EasySensors/easyPIRmultisensorsBox2/pics/Easy_PIR_Back.png

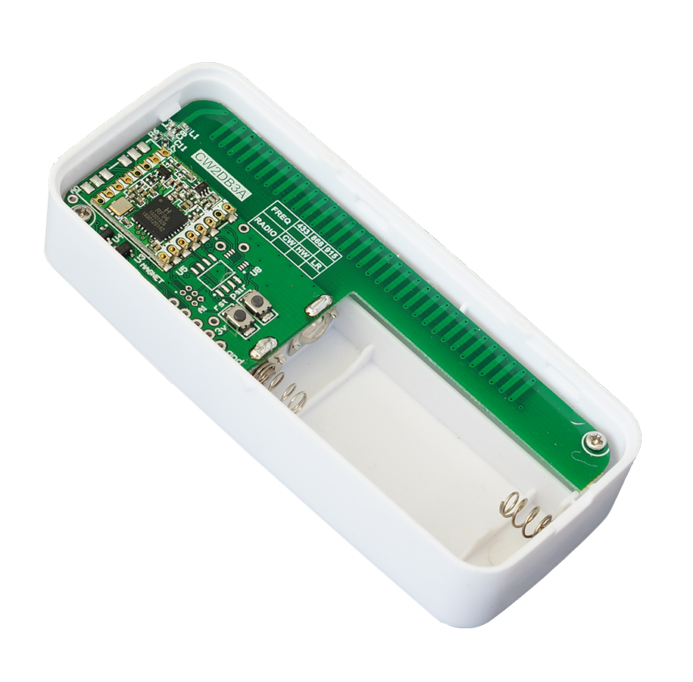
pics/Easy_PIR_Back.png
