EasySensors/easyPIRmultisensorsBox2/pics/Easy_PIR_MAIN.jpg

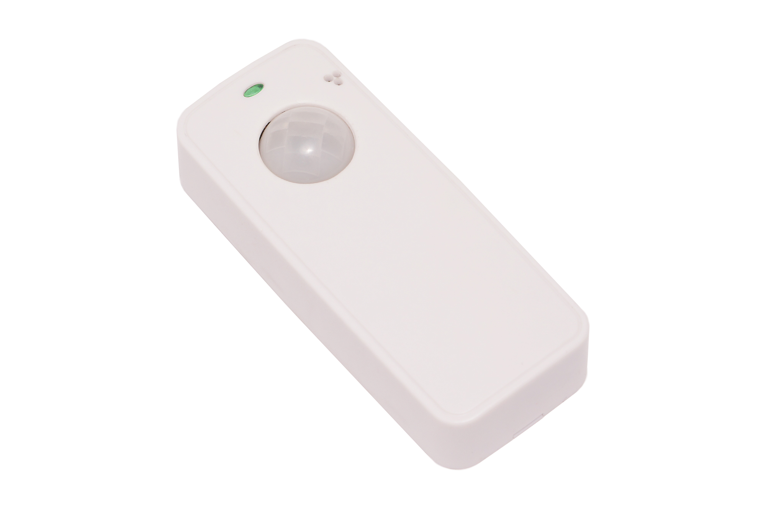
pics/Easy_PIR_MAIN.jpg
