EasySensors/easyPIRmultisensorsBox2/pics/Easy_PIR_PCB_TOP.jpg

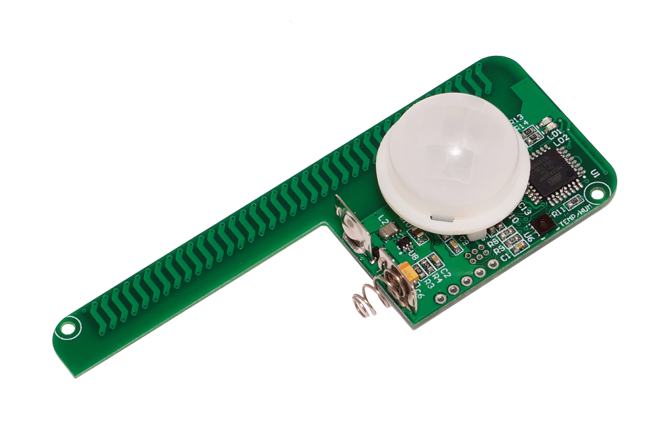
pics/Easy_PIR_PCB_TOP.jpg
