EasySensors/easyPIRmultisensorsBox2/pics/Easy_PIR_TOP.png

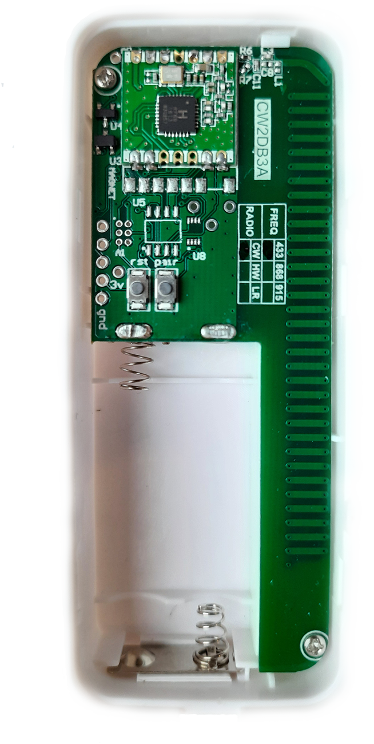
pics/Easy_PIR_TOP.png
