EasySensors/easyPIRmultisensorsBox2/pics/replcePIR2.jpg

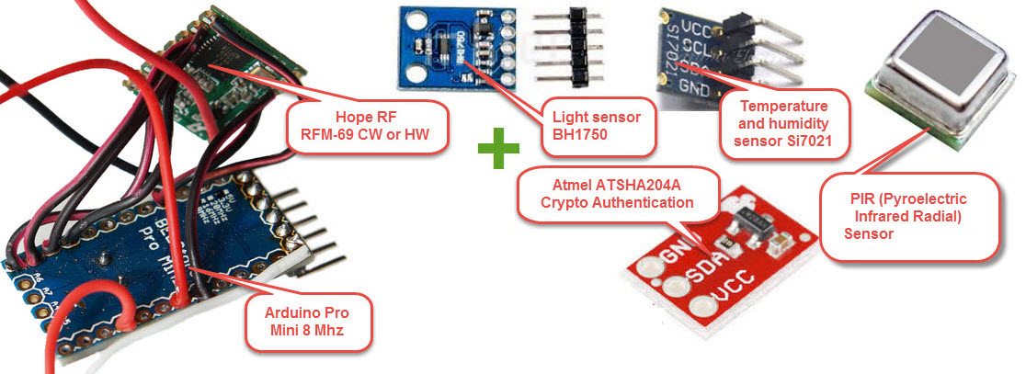
pics/replcePIR2.jpg
