EasySensors/easyPIRmultisensorsBox2/UNIVERSAL_WINDOW_SENSOR_NEWTEMPHUM_FLOOD.PDF

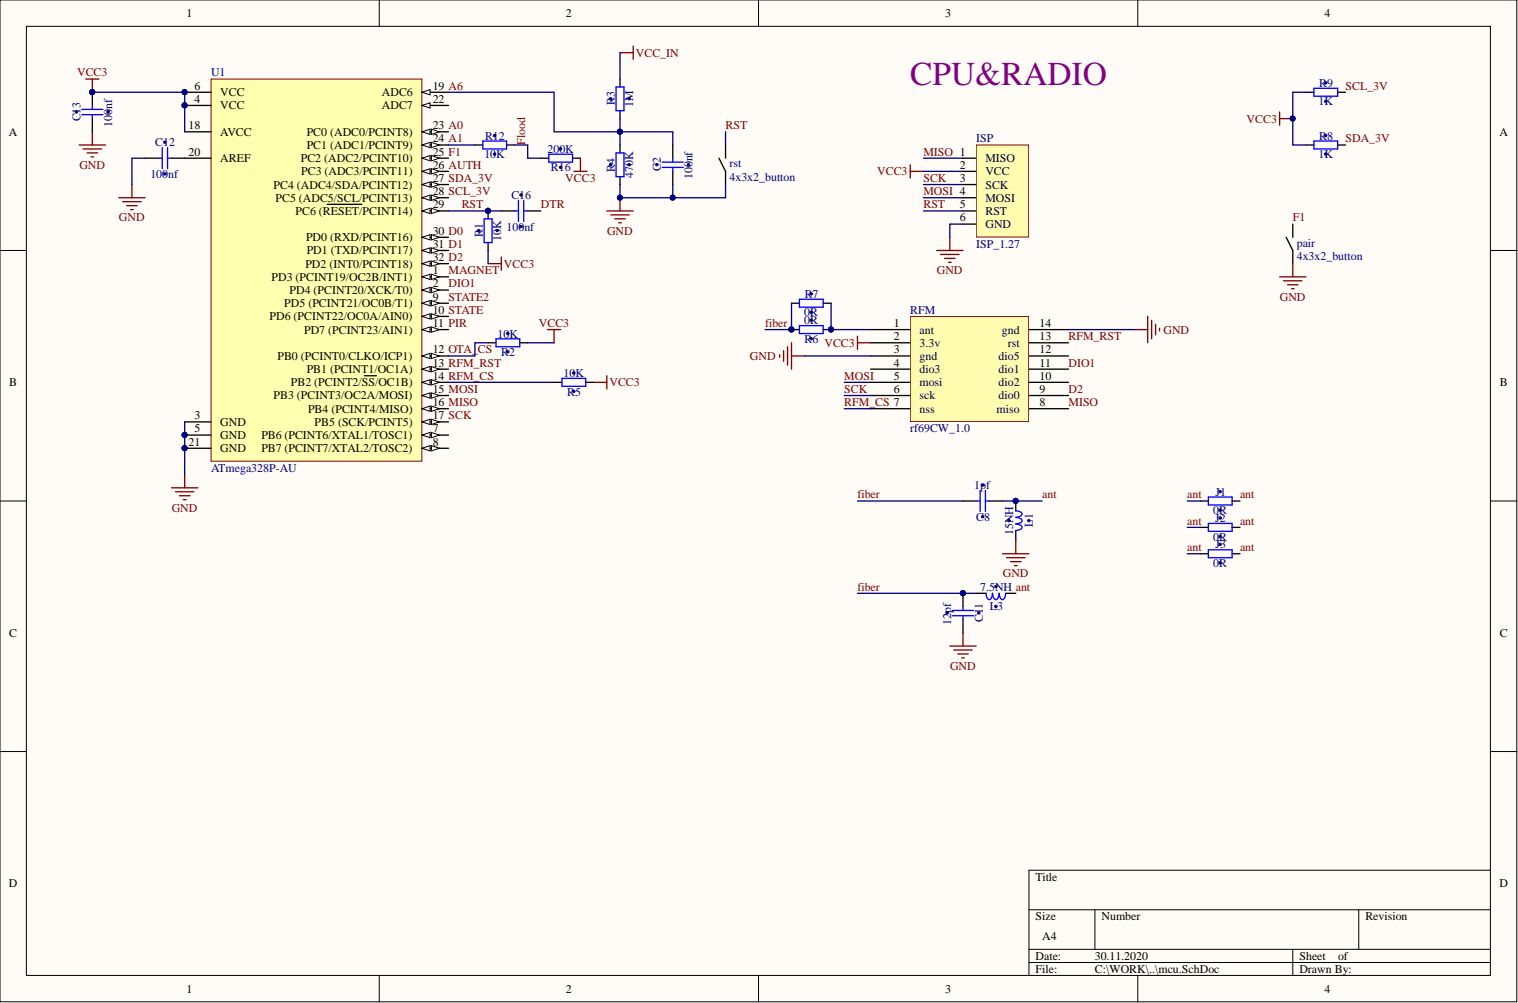
[picture p10: page 1]

AREF 20 | R12

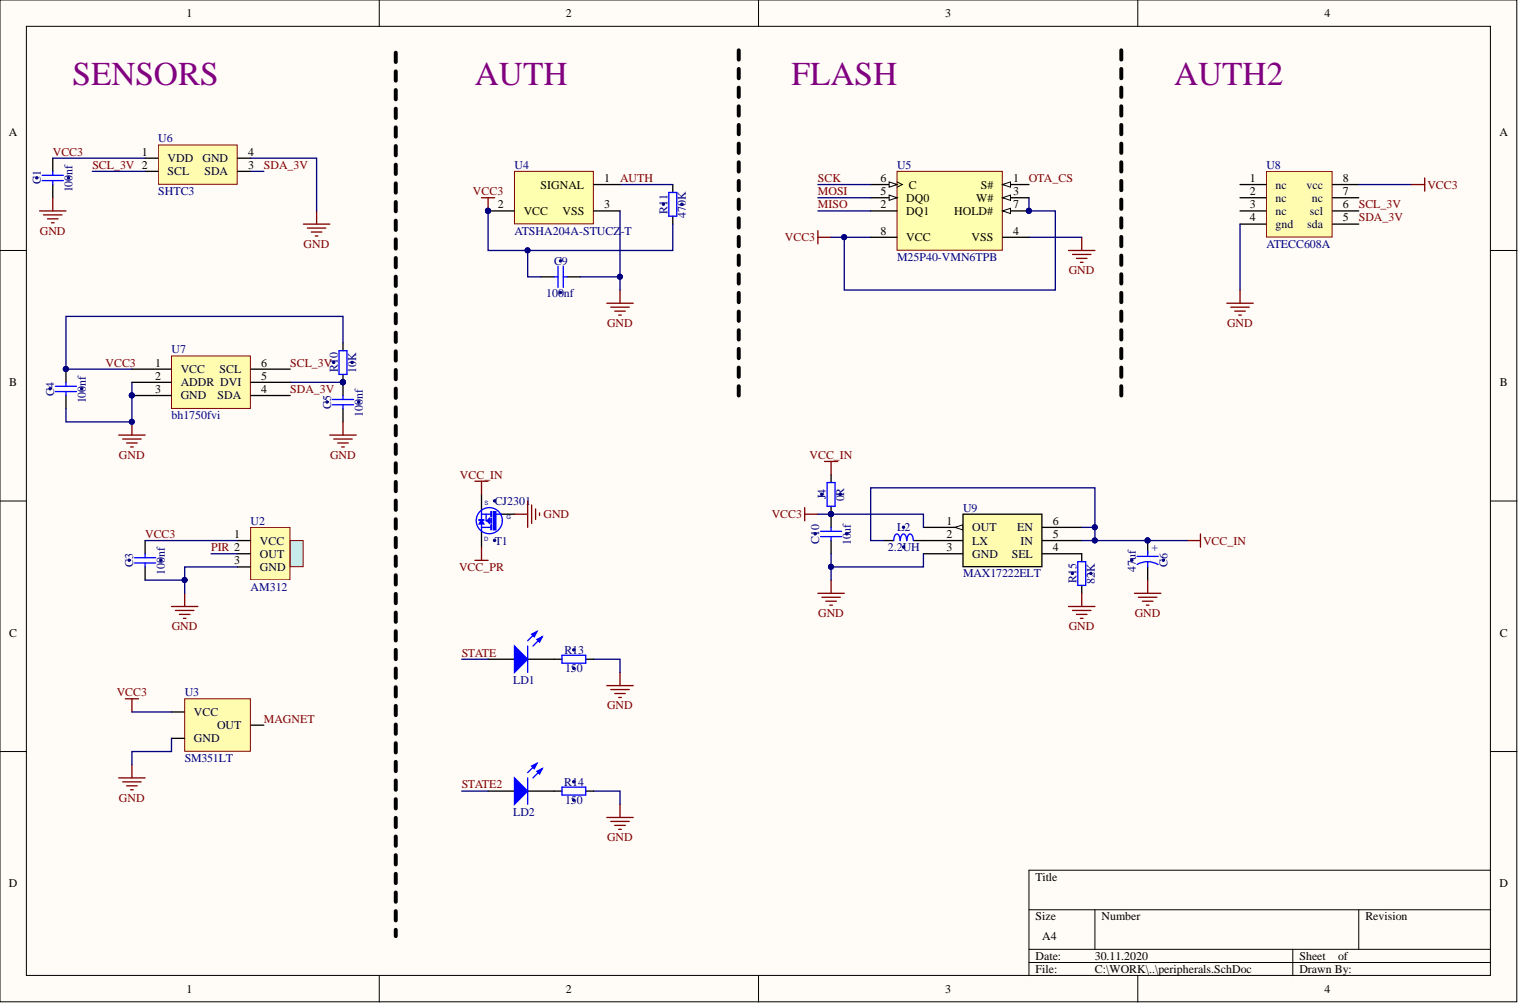
[picture p11: page 2]
