EasySensors/easyPIRmultisensorsBox2/(commit log)

2019-12-05 New version schematics
2019-12-19 universal code for both PIR and door sensor
2020-04-29 DummyDimmerLUXvalue_sensor added battery level report corrected
    This sensor used as PIR trigger threshold. it is possible to adjust it if added as a DIMMER switch in the controller
2020-10-20 additional sensor PIR sensor report
    - Now PIR sensor can report both above and below LUXTHRESHOLD events to different sensor IDs. Useful when you need to detect occupancy
    - Some sensors like temperature sensor can be disabled for data reporting. saving the battery
2021-03-29 Sleep time and dead battery detection
    Possible to set wakeup interval for periodical sensor reports SENSORS_REPORT_TIME_MS
    If combined batteries voltage below is 2 volts sensor sleep forever and not trying to do anything and flooding radio with presentation attempts
2021-06-08 Door sensor version pullup issue fixed
    [easyPirPCINTdoorSensorTindie.ino]
2021-06-08 #define TEMP_HUM_SENSOR_SHTC3 selected as default Temp sensor
