EasySensors/easyPIRmultisensorsBox2/(notices)

Notices in the files:
easyPirPCINTdoorSensorTindie.ino:
modify it under the terms of the GNU General Public License
